ISMR-Labs/grain-acoustics/paper/grain-acoustics.pdf

# A Low-Cost Networked Acoustic and Vibration Sensor Node for Early Detection of Insects in Bagged Rice

Dilan Perera
Intelligent Systems & Mechatronics Research Laboratory (ISMR Labs) Colombo, Sri Lanka
https://github.com/ISMR-Labs/grain-acoustics

Abstract—Stored-product insects infest retail rice bags long before damage is visible from outside the bag. Acoustic detection of hidden insects in grain is well established with laboratorygrade sensors, but no cheap networked sensor exists that a warehouse could attach to a bag. This paper describes the design and first characterisation of such a node. An ESP32 microcontroller samples two I2S MEMS microphones at 16 kHz and two bare piezoelectric contact discs at 8 kHz and streams every sample over Wi-Fi in 100 ms HTTP chunks (about 104 kB/s) to a self-hosted server that visualises the four channels live, records sessions as WAV with metadata, and exports every channel separately. We report the hardware, firmware and protocol, two problems met during bring-up (a second microphone that cannot share the I2S data line, and the loss of DMA ADC sampling once both I2S peripherals are taken) and their solutions, and a baseline characterisation of the four channels. The microphones reach a noise floor of −26 dBFS to −32 dBFS and agree within 1 dB. The bare piezo channels are dominated by 50 Hz mains pickup 30 dB above the surrounding spectrum and clip on 7–15 % of samples, so a charge amplifier and shielded leads are required before insect trials. The complete design, recordings and analysis scripts are published as an open repository.
Index Terms—stored-product insects, acoustic detection, biotremology, piezoelectric sensor, MEMS microphone, ESP32, rice
I. INTRODUCTION
Rice is sold in Sri Lanka in 5 kg retail bags that are stacked in warehouses for weeks. A few adult rice weevils (Sitophilus oryzae), lesser grain borers (Rhyzopertha dominica) or red flour beetles (Tribolium castaneum) in a sealed bag are invisible, and by the time frass or holes appear the whole stack is affected. Insects inside grain are not silent: feeding, chewing and walking produce trains of short broadband impulses that propagate as airborne sound and as substrate vibration through the packed kernels [1], [2]. Acoustic detection of hidden stored-grain insects has been demonstrated since the early 1990s with probe sensors and laboratory amplifiers [3], [4], has been automated with pattern recognition [5], [6], and recent reviews point to low-cost microcontroller platforms as the next step [7]. Contact piezo microphones in 3D-printed housings have also been shown to be adequate for biotremology of small insects [8].
This work asks three questions. (1) Can a low-cost MEMS microphone and a bare piezo disc coupled to a sealed bag capture insect signals above the warehouse noise floor? (2)

TABLE I
SENSOR NODE PIN MAP
ESP32 pin | Function | Connection
GPIO 26 / 25 / 33 | I2S1 BCLK / WS / DIN | Mic A SCK / WS / SD
GPIO 14 / 27 / 32 | I2S0 BCLK / WS / DIN | Mic B SCK / WS / SD
GPIO 34 | ADC1 ch 6 | Piezo 1 network
GPIO 35 | ADC1 ch 7 | Piezo 2 network
GPIO 4 | output | status LED
3V3 / GND | power | mics, bias divider, clamps

Which coupling, airborne, contact on the bag wall, or probe in the grain, gives the best signal-to-noise ratio for the smallest insects? (3) Can the resulting recordings train a detector that flags an infested bag early? This paper covers the platform built to answer them and its baseline characterisation; insect trials are future work.

II. SYSTEM DESIGN

A. Sensor node
The node (Fig. 1) is built around an ESP32-WROOM-32U development board with an external 2.4 GHz antenna. Two INMP441 I2S MEMS microphones [9] provide the airborne channels and two 27 mm brass piezo discs the contact channels. The discs are used bare, without an amplifier, as a deliberate first pass to establish what the ADC alone can resolve. Each disc feeds an ESP32 ADC pin through 100 kΩ, with a 1 MΩ load to a 0.55 V bias node and a BAT54S Schottky pair clamping knocks to the rails. The ADC runs at 0 dB attenuation (0 V to 1.1 V window), so one count is about 0.27 mV at the pin.
Table I lists the pin assignment. Each microphone has its own I2S peripheral; the reason is discussed in Section III.
B. Enclosures
Three enclosures were designed in OpenSCAD and printed on a Creality Ender-3 V3 SE: a controller box (inner 20×70× 40 mm, USB-C cutout, four 4 mm cable glands), a microphone pod (30×30×8.7 mm, four-hole grille), and a piezo pad (57× 57 × 5.5 mm, 3 mm cavity, 2 mm contact floor) modelled on the contact microphone box of [8]. Walls are 1.35 mm, exactly three extrusion lines, so the slicer produces clean perimeters around the cable holes.


Fig. 1. The node: controller box with four cable glands, two 57 mm piezo pads and two 30 mm microphone pods, all 3D-printed in PLA+.

C. Firmware
The firmware runs on Arduino-ESP32 3.3 over ESP-IDF 5. Two independent I2S standard-mode receive channels capture 32-bit Philips stereo frames at 16 kHz; the left slot is kept and bits 29..14 of the 24-bit sample become an int16. To keep both DMA rings small (4 descriptors of 256 frames) each 100 ms chunk is read in two 50 ms halves per microphone. The piezos are sampled by a 1 MHz hardware timer whose interrupt notifies a high-priority FreeRTOS task; the task performs two one-shot ADC conversions per tick into a ring buffer. The measured rate is 7987 Hz to 8013 Hz. A queue of six chunk buffers decouples capture from an HTTP task that POSTs each chunk with keep-alive; if Wi-Fi stalls, chunks are dropped rather than delayed, and the server zero-fills the gap so recordings remain on a continuous time axis. Over-the-air updates are supported.
D. Protocol and server
Each chunk carries a 32-byte little-endian header (magic SNS1, sequence number, uptime, both sample rates, frame counts, flags) followed by interleaved int16 microphone samples and interleaved uint16 raw ADC counts. The server is a FastAPI application in Docker behind a TLS reverse proxy. It fans chunks out to browser clients over WebSocket through bounded per-client queues, writes recordings as mics.wav (2 ch, 16 kHz) and piezo.wav (2 ch, 8 kHz, ADC − 2048) with a JSON sidecar, and exports each channel as a mono WAV. The dashboard (Fig. 2) shows four oscilloscopes with live spectra, RMS and peak levels, a record button and a recordings table with one download link per channel. A 0.4 s jitter buffer keeps the display smooth at 30 fps.

III. BRING-UP PROBLEMS AND SOLUTIONS

A. Second microphone on a shared data line
The INMP441 is designed so that two devices share one data line, one per stereo slot, selected by the L/R pin. In


Fig. 2. Node streaming to the live dashboard: two microphone scopes (top) and two piezo scopes (bottom), each with its spectrum.

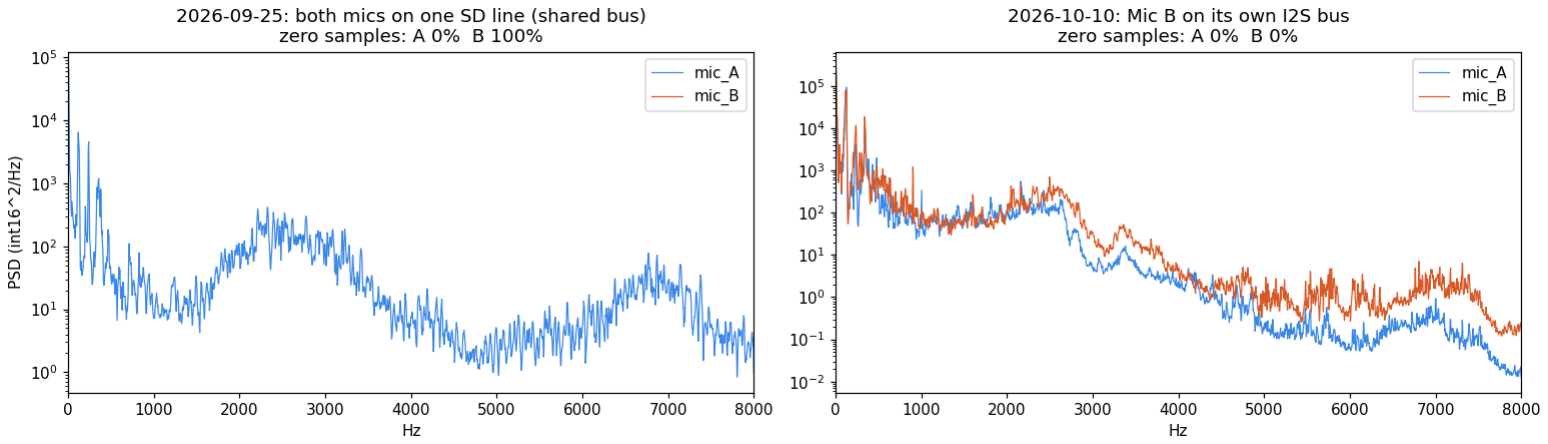
[picture p14: figure]

Fig. 3. Power spectral density of both microphones before (left, shared data line, Mic B 100 % zeros) and after (right, separate buses) the change.

our build the second microphone never drove the line, and whenever it was connected the first microphone’s stream was corrupted: 74 % zero samples with a 640 ms periodic bit pattern. Swapping modules, pins and L/R ties did not change the symptom. Moving Mic B to the ESP32’s second I2S peripheral (I2S0) on its own three pins fixed both faults at once (Fig. 3). The second i2s_new_channel call initially failed to allocate DMA memory; reducing the DMA ring to 4×256 frames per channel and reading in halves resolved it.

B. Loss of DMA ADC sampling

On the classic ESP32 the continuous (DMA) ADC driver borrows the I2S0 peripheral. Once Mic B occupied I2S0, DMA sampling of the piezos became impossible. The timerplus-task design in the firmware section replaced it; the cost is 0.3 % rate jitter, which the server tolerates by trusting the per-chunk frame count rather than a nominal rate.

IV. BASELINE CHARACTERISATION

Two sessions recorded on 10 October 2026 with the final wiring were analysed with the repository’s spectrogram.py (Welch PSD, 4096-point segments). Session A (23.1 s) included deliberate handling, taps and speech near the sensors; Session B (8.2 s) was a quiet bench with the node resting on a table. Table II summarises the levels and Fig. 4 shows Session A.

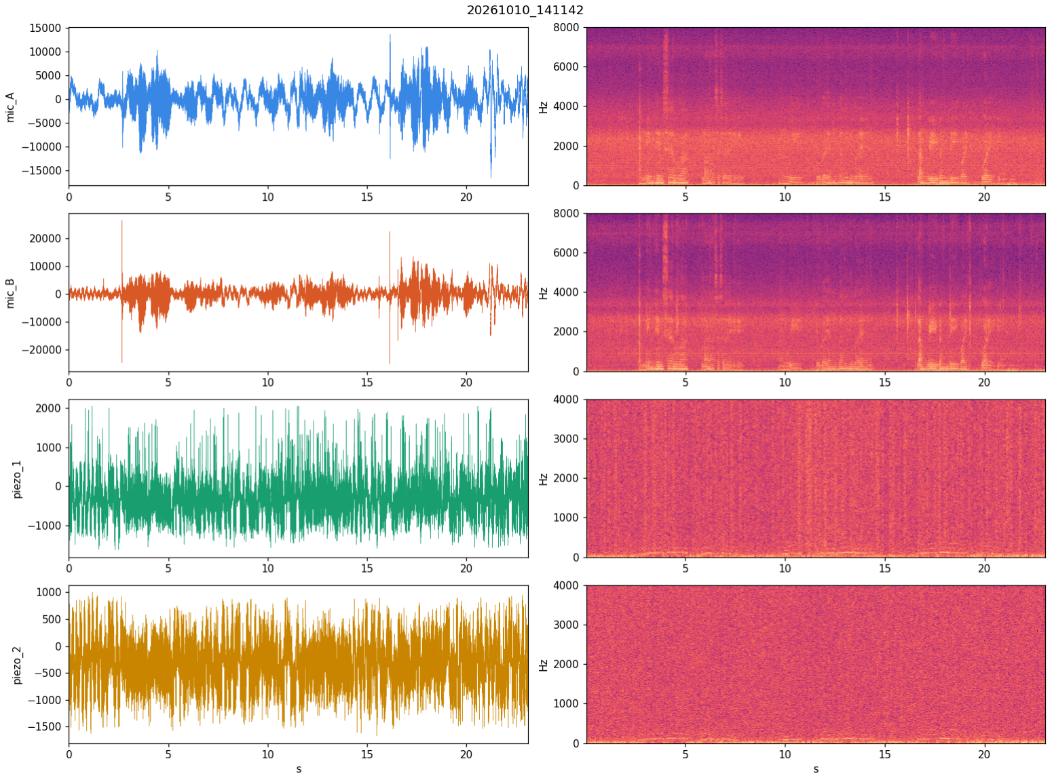
[picture p15: figure]

Fig. 4. Session A: waveforms (left) and spectrograms (right) of both microphones (16 kHz) and both piezo channels (8 kHz). Speech and handling are visible on the microphones; the piezo channels show broadband noise and a 50 Hz line.

TABLE II
CHANNEL LEVELS (0 DBFS = ADC OR INT16 FULL SCALE)
Sess. Channel | RMS | Peak | Clip % | 50 Hz
| | dBFS | dBFS | | excess dB
A | mic A | −22.5 | −5.9 | 0.0 | 1.9
A | mic B | −23.1 | −1.9 | 0.0 | 0.9
A | piezo 1 | −12.9 | 0.0 | 0.0 | −0.9
A | piezo 2 | −12.8 | −1.8 | 0.0 | −0.7
B | mic A | −26.4 −16.5 | 0.0 | −4.9
B | mic B | −31.7 −19.7 | 0.0 | −3.3
B | piezo 1 | −5.0 | 0.0 | 6.9 | 30.7
B | piezo 2 | −3.6 | 0.0 | 15.5 | 31.6

The two microphones agree within 1 dB in level and spectrum, and their quiet-bench floor is −26 dBFS to −32 dBFS, dominated by energy below 100 Hz (93–94 % of the total), which is room rumble through the table rather than electrical noise. The bare piezo channels behave differently: on the quiet bench the 50 Hz mains component sits 31 dB above the median of the surrounding band, the RMS level is only 4 dB to 5 dB below full scale, and 7–15 % of samples are clipped. Any insect signal, expected in the tens of microvolts at the bag wall, is far below this floor.

V. DISCUSSION AND NEXT STEPS
The platform meets its streaming and recording goals: fullrate capture of four channels, lossless accounting of dropped chunks, and per-channel export. The microphone channels are ready for coupling experiments. The piezo channels are not. Three changes are planned before insect trials: shielded leads with the shield grounded at the box, a lower load resistor (470 kΩ) to reduce hum pickup, and a per-channel LM324 charge amplifier (gain about 1000, 300 Hz to 5000 Hz bandpass) biased to the ADC mid-scale, which needs no firmware change. For mounting, a thin hard bond of the brass face to a stiff metal plate or a probe pushed into the grain is preferred over hot glue on plastic, which damps the 1 kHz to 5 kHz band in which stored-grain insect impulses are reported [1].
The experimental plan then follows the literature: a onehour warehouse baseline on an empty table and on a clean sealed bag; seeded bags with 10, 50 and 200 adult S. oryzae and matched controls, each recorded for 24 h with sensors in all four coupling positions, logging temperature because adult activity is strongly temperature dependent [3]; and an impulsecount detector in the style of [4] as the first classifier.

VI. CONCLUSION
A networked four-channel acoustic and vibration sensor node for bagged rice was built from a 5 USD microcontroller, two MEMS microphones and two piezo discs, together with a recording platform that exports every channel for analysis. Bring-up showed that two INMP441 microphones should be given separate I2S peripherals on the ESP32, which in turn forces timer-paced ADC sampling. The microphones are quiet and matched; the bare piezo discs need a preamplifier and shielding before they can detect small insects. All hardware designs, firmware, server code, recordings and analysis scripts are available in the project repository [10].

REFERENCES

[1] R. W. Mankin, D. W. Hagstrum, M. T. Smith, A. L. Roda, and M. T. K. Kairo, “Perspective and promise: a century of insect acoustic detection and monitoring,” American Entomologist, vol. 57, no. 1, pp. 30–44, 2011.
[2] P. S. M. Hill and A. Wessel, “Biotremology,” Current Biology, vol. 26, no. 5, pp. R187–R191, 2016.
[3] D. W. Hagstrum and P. W. Flinn, “Comparison of acoustical detection of several species of stored-grain beetles over a range of temperatures,” Journal of Economic Entomology, vol. 86, no. 4, pp. 1271–1278, 1993.
[4] D. Shuman, J. A. Coffelt, K. W. Vick, and R. W. Mankin, “Quantitative acoustical detection of larvae feeding inside kernels of grain,” Journal of Economic Entomology, vol. 86, no. 3, pp. 933–938, 1993.
[5] I. Potamitis, T. Ganchev, and D. Kontodimas, “On automatic bioacoustic detection of pests: the cases of Rhynchophorus ferrugineus and Sitophilus oryzae,” Journal of Economic Entomology, vol. 102, no. 4, pp. 1681–1690, 2009.
[6] P. A. Eliopoulos, I. Potamitis, D. C. Kontodimas, and E. G. Givropoulou, “Detection of adult beetles inside the stored wheat mass based on their acoustic emissions,” Journal of Economic Entomology, vol. 108, no. 6, pp. 2808–2814, 2015.
[7] R. W. Mankin, D. Hagstrum, M. Guo, P. Eliopoulos, and A. Njoroge, “Automated applications of acoustics for stored product insect detection, monitoring, and management,” Insects, vol. 12, no. 3, p. 259, 2021.
[8] I. Gjonov, A. Lapeva-Gjonova, and M. Pramatarova, “Biotremological research using a DIY piezoelectric contact microphone: examples with insects,” Biodiversity Data Journal, vol. 13, p. e143481, 2025.
[9] TDK InvenSense, “INMP441: omnidirectional microphone with bottom port and I2S digital output, datasheet,” https://invensense.tdk.com/products/digital/inmp441/, (https://invensense.tdk.com/products/digital/inmp441/) 2014.
[10] D. Perera, “grain-acoustics: acoustic and vibration sensing of stored-grain insects in bagged rice,” https://github.com/ISMR-Labs/grain-acoustics, (https://github.com/ISMR-Labs/grain-acoustics) 2026.
