ISMR-Labs/grain-acoustics/docs/figures/20261010_150038_overview.png

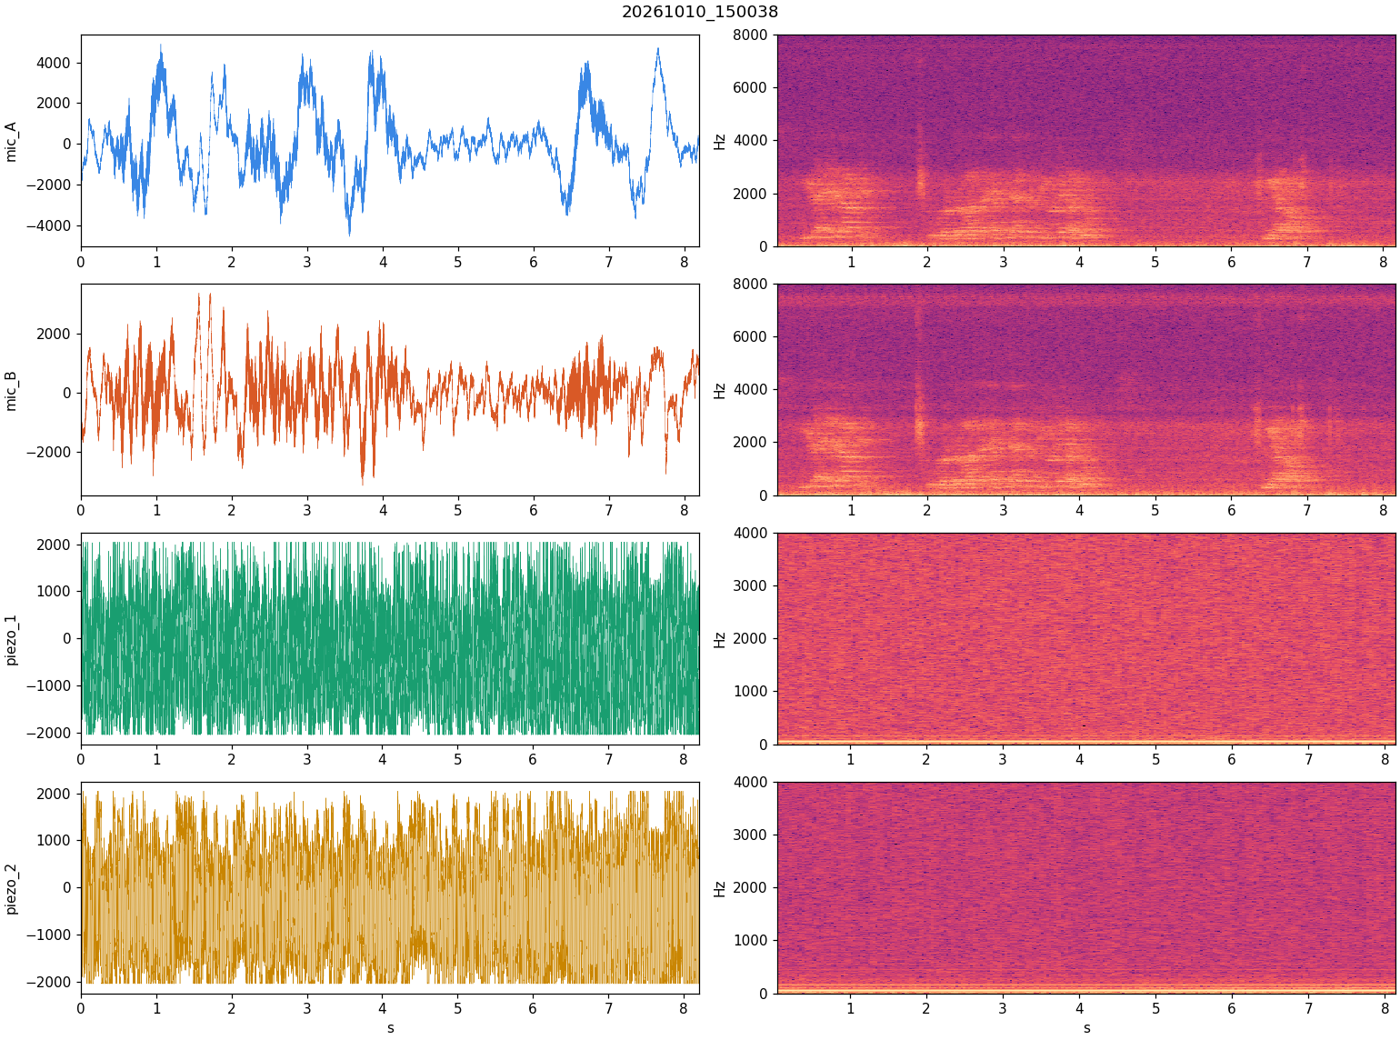
docs/figures/20261010_150038_overview.png
