ISMR-Labs/grain-acoustics/hardware/enclosures/controller-box/controller-box-front.png

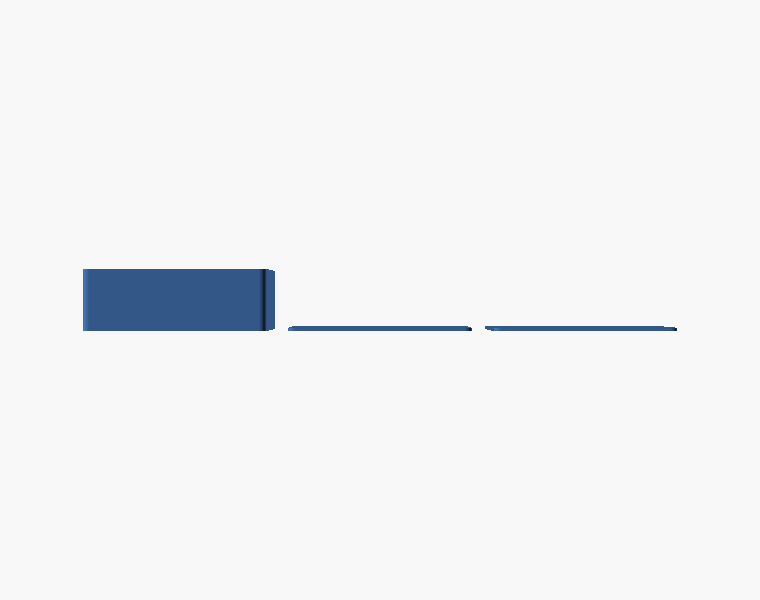
hardware/enclosures/controller-box/controller-box-front.png
