ISMR-Labs/grain-acoustics/hardware/enclosures/controller-box/controller-box-top.png

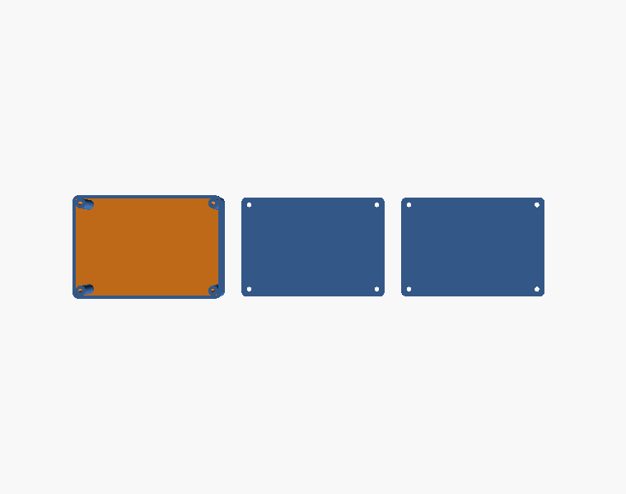
hardware/enclosures/controller-box/controller-box-top.png
