ISMR-Labs/grain-acoustics/hardware/enclosures/esp32-controller-box/esp32-controller-box-front.png

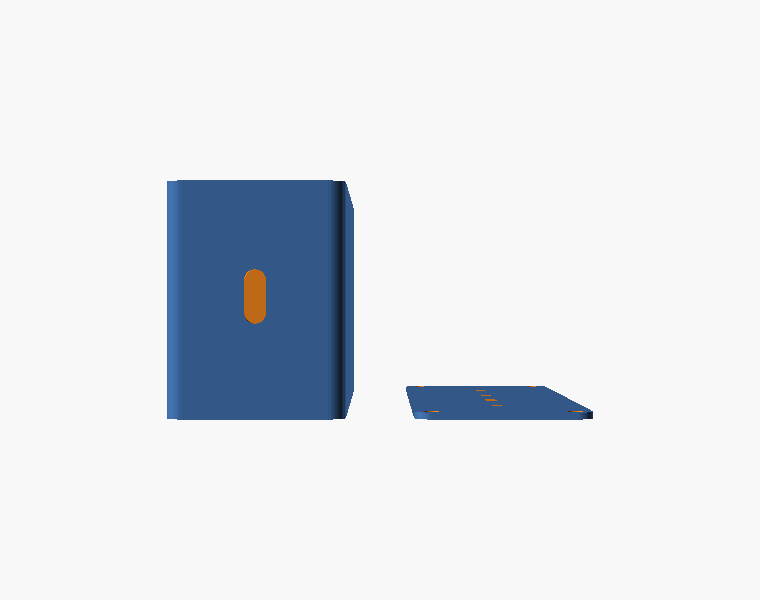
hardware/enclosures/esp32-controller-box/esp32-controller-box-front.png
