ISMR-Labs/grain-acoustics/hardware/enclosures/mic-box/mic-box-front.png

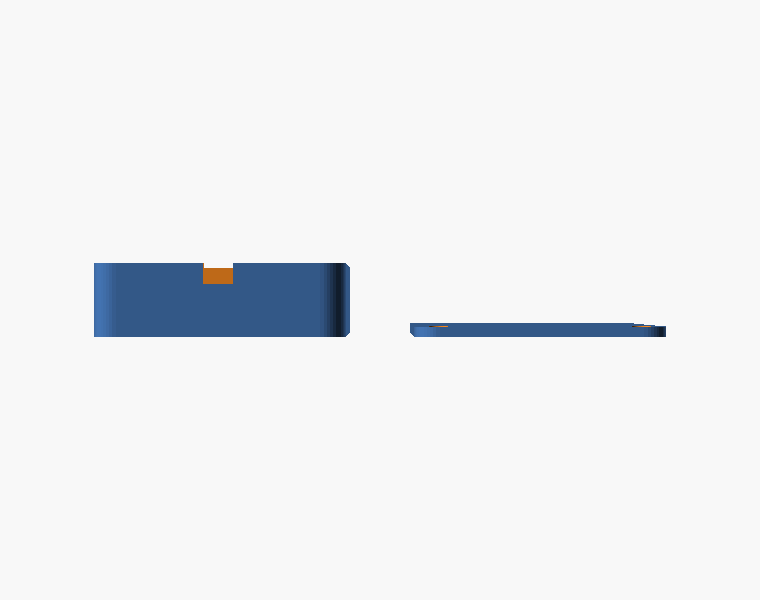
hardware/enclosures/mic-box/mic-box-front.png
