ISMR-Labs/grain-acoustics/hardware/enclosures/vibration-motor-enclosure/vibration-motor-enclosure-top.png

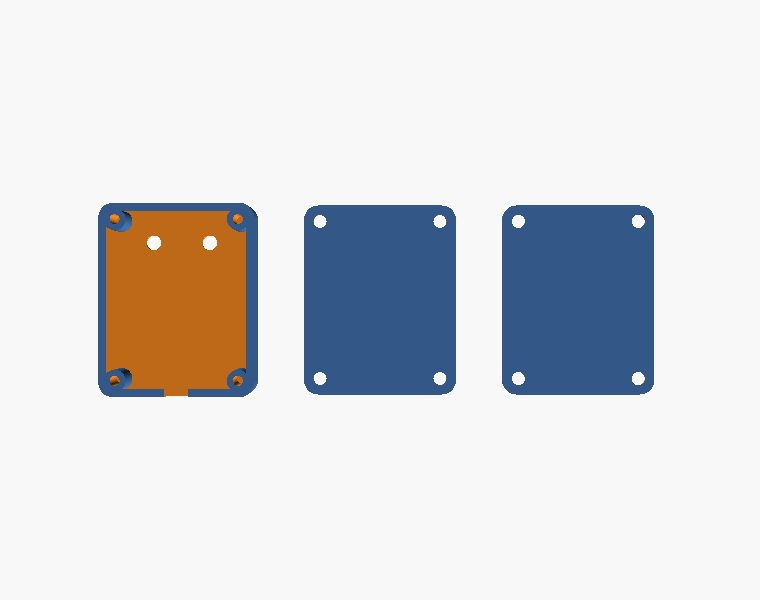
hardware/enclosures/vibration-motor-enclosure/vibration-motor-enclosure-top.png
