ISMR-Labs/grain-acoustics/media/photos/2026-09-24-vibration-array/IMG_7175.jpg

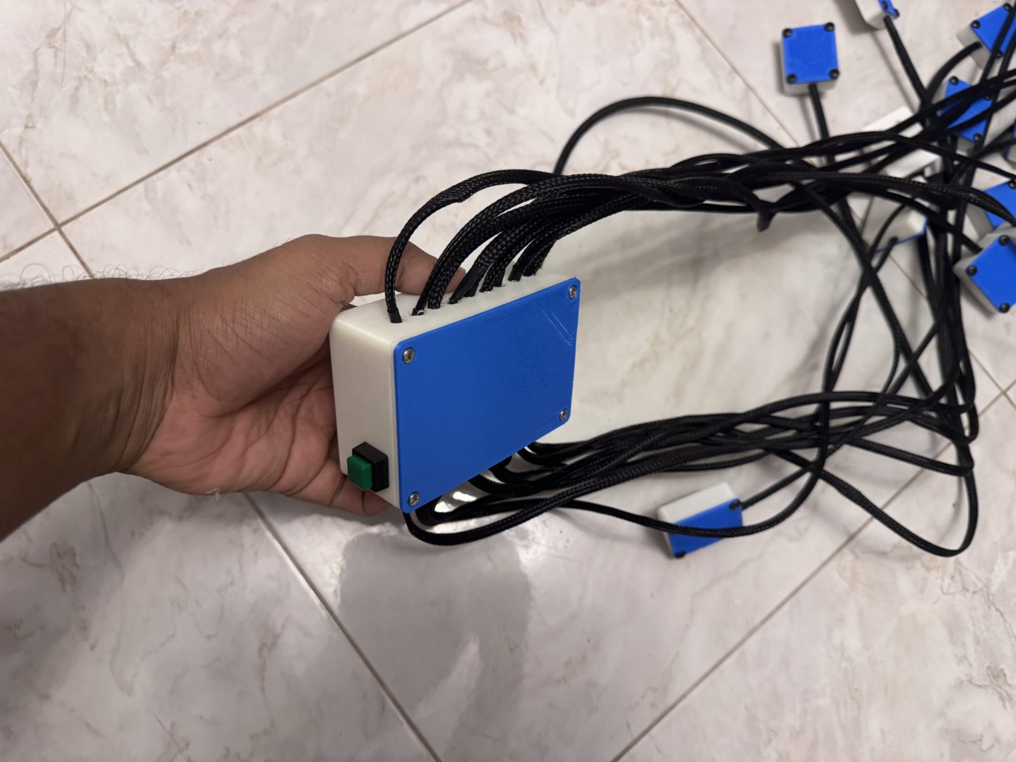
media/photos/2026-09-24-vibration-array/IMG_7175.jpg
