ISMR-Labs/grain-acoustics/media/photos/2026-10-10-sensor-node/IMG_7225.jpg

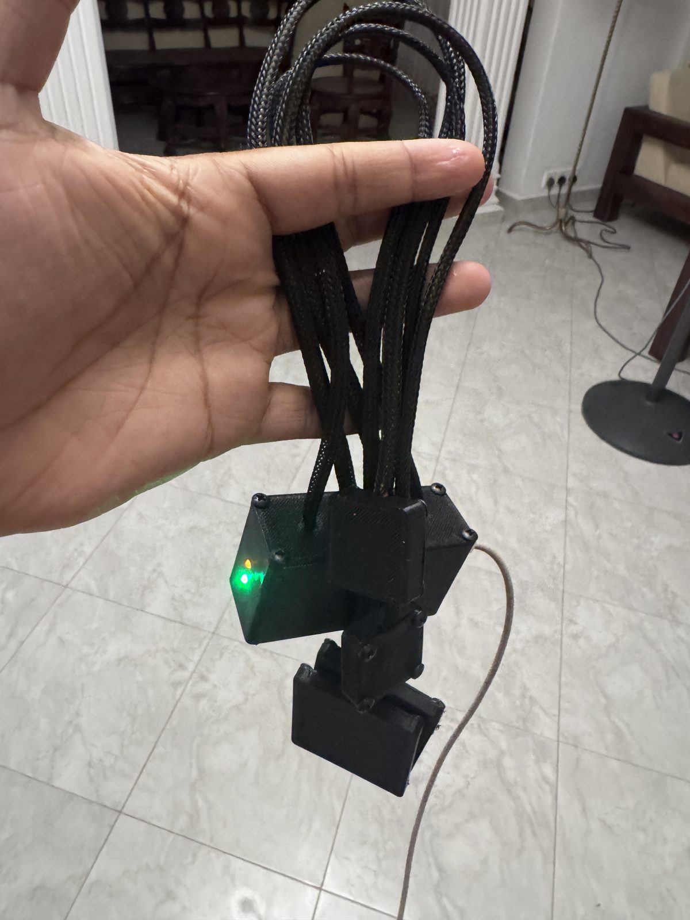
media/photos/2026-10-10-sensor-node/IMG_7225.jpg
