ISMR-Labs/grain-acoustics/media/screenshots/dashboard-live-2.png

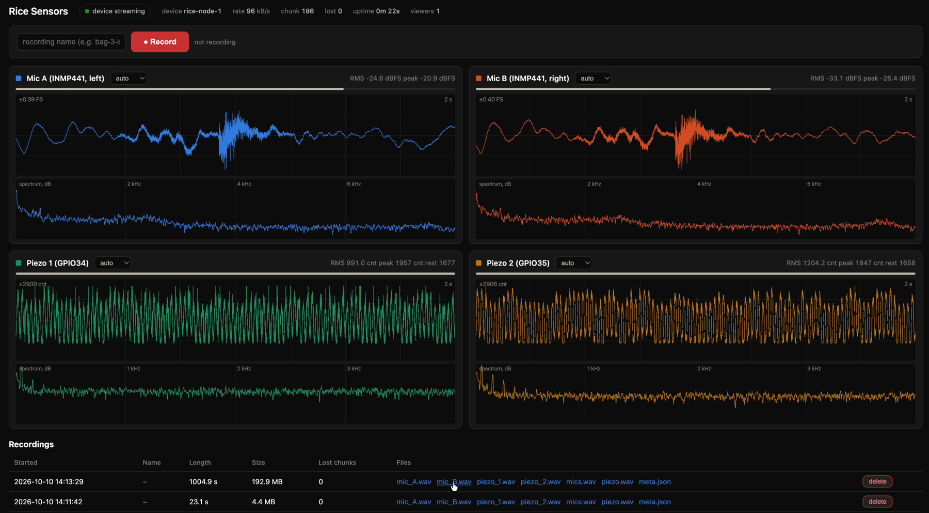
media/screenshots/dashboard-live-2.png
