ISMR-Labs/grain-acoustics/media/screenshots/dashboard-live-3.png

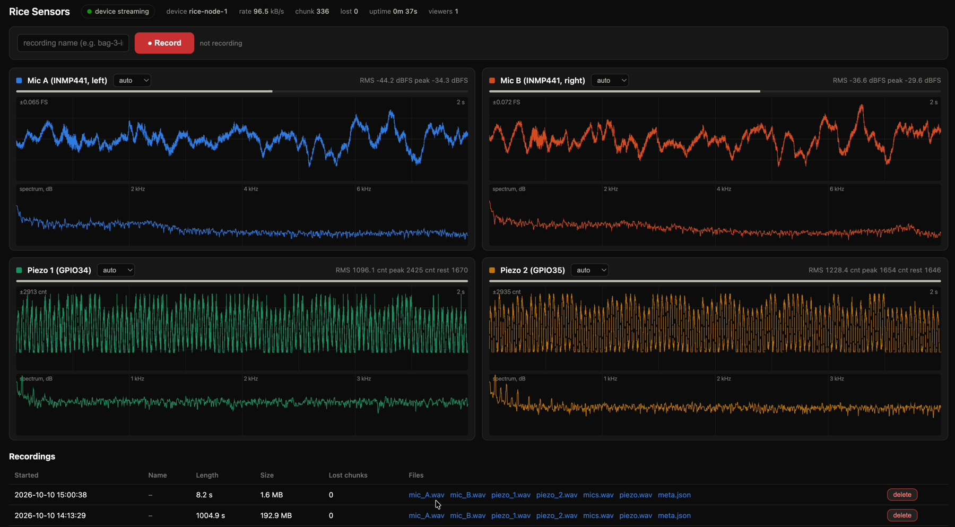
media/screenshots/dashboard-live-3.png
