ISMR-Labs/grain-acoustics/media/video/node-live-dashboard-2026-10-10.jpg

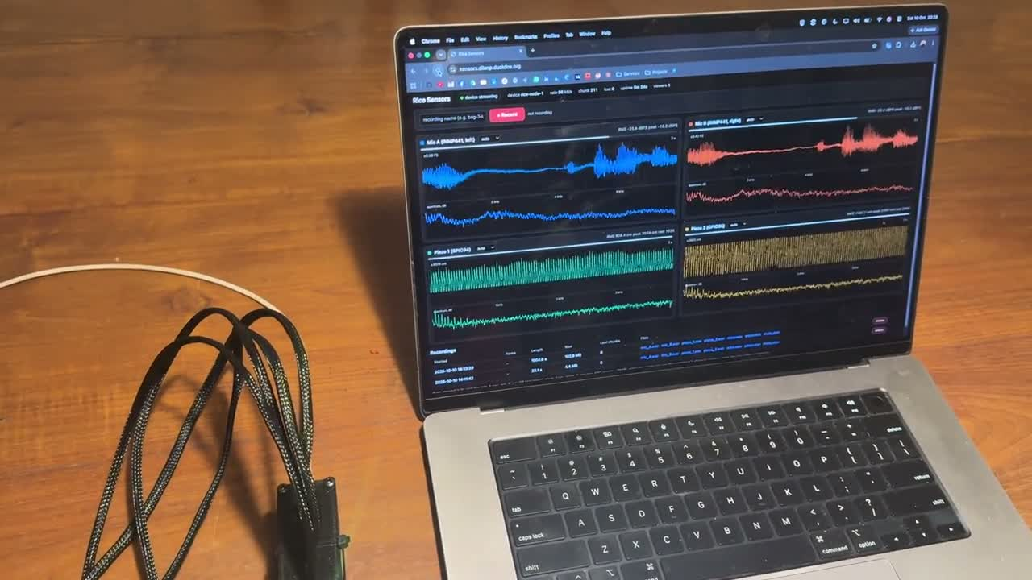
media/video/node-live-dashboard-2026-10-10.jpg
