ISMR-Labs/grain-acoustics/media/video/vibration-array-demo-2026-09-24.jpg

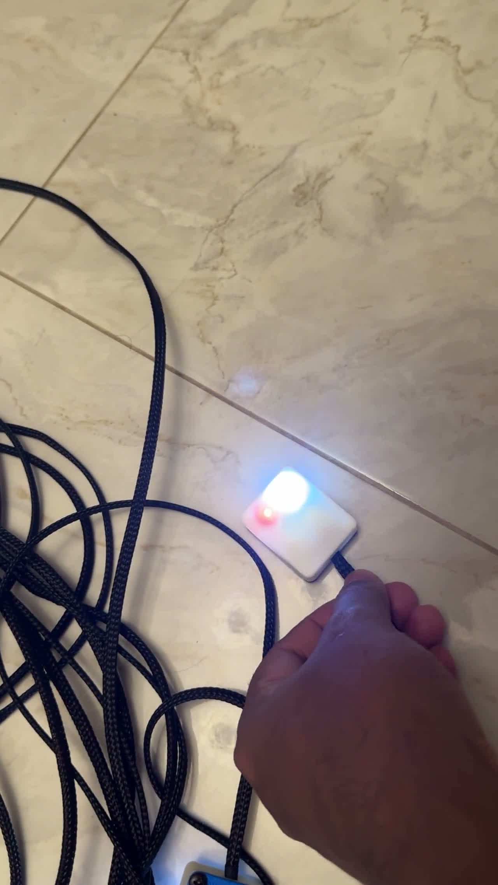
media/video/vibration-array-demo-2026-09-24.jpg
