ISMR-Labs/grain-acoustics/hardware/enclosures/esp32-controller-box/esp32-controller-box.stl

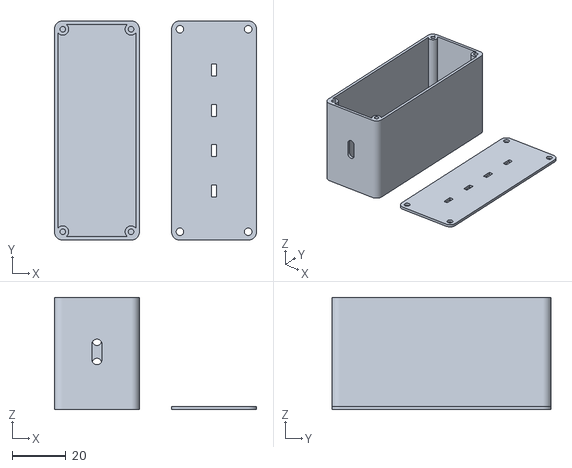
[picture p53: CAD file, 2026-10-10]
hardware/enclosures/esp32-controller-box/esp32-controller-box.stl
75.2 x 81.6 x 41.7
