ISMR-Labs/grain-acoustics/hardware/enclosures/mic-box/mic-box.stl

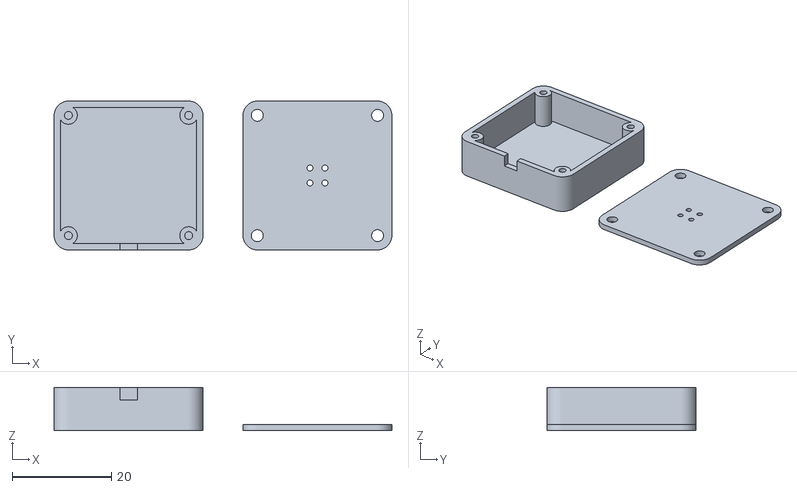
[picture p54: CAD file, 2026-10-10]
hardware/enclosures/mic-box/mic-box.stl
68.0 x 30.0 x 8.70
