ISMR-Labs/grain-acoustics/hardware/enclosures/piezo-box/piezo-box.stl

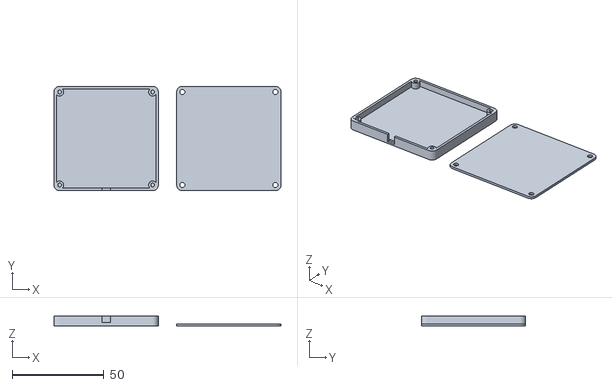
[picture p55: CAD file, 2026-10-10]
hardware/enclosures/piezo-box/piezo-box.stl
124.0 x 57.0 x 5.50
