ISMR-Labs/grain-acoustics/hardware/enclosures/vibration-motor-enclosure/vibration-motor-enclosure.stl

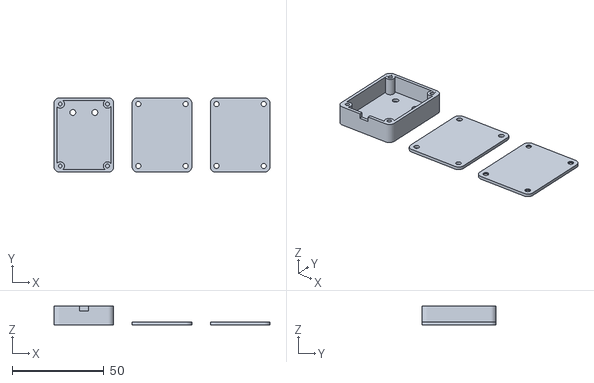
[picture p56: CAD file, 2026-10-10]
hardware/enclosures/vibration-motor-enclosure/vibration-motor-enclosure.stl
117.5 x 40.5 x 10.1
