ISMR-Labs/grain-acoustics/(list of files, cad)

Other CAD files:
hardware/enclosures/vibration-motor-enclosure/vibration-motor-enclosure.scad
hardware/enclosures/piezo-box/piezo-box.scad
