ISMR-Labs/grain-acoustics/(commit log)

2026-10-10 Initial import: sensor node, servers, enclosures, recordings, docs
    [esp32-controller-box.scad, esp32-controller-box.stl, mic-box.scad, mic-box.stl, piezo-box.scad, piezo-box.stl]
2026-10-10 Add vibration-array companion enclosures (module pod, controller box) from Forge with STL, renders and G-code
    [controller-box.scad, controller-box.stl, vibration-motor-enclosure.scad, vibration-motor-enclosure.stl]
